jcjones94/drone/tutorial/parts.md

# List of parts with model number

* mpu 6050 gryo/accelerometer 

* Makerfire ESC 20A BLHeli Brushless Speed Controller

* Elegoo UNO R3 Board ATmega328P

* UCEC XY-MK-5V / XY-FST 433Mhz Rf Transmitter and Receiver

* A2212 1000KV Brushless Outrunner Motor

* 3 cell 3300mha 25-50c lipo battery
