jcjones94/drone/(threads)

Thread 1 (2017-07-06):

drone drift

jcjones94, 2017-07-06:
with my current code the drone continues to drift. I've tried adjusting the power to the motors but this process is tedious.  the drift is most likely because the gyro isn't level on the drone and the gyro/accelerometer has values that drift over time.

jcjones94, 2017-08-11:
I've found out that the drifting of the drone is most likely do to vibrations effecting the MPU6050. i believe the vibrations are so strong that its causing a buffer overflow on the acceleration data in the x and y plane which is causing angle shifts. I've concluded this because once the drones throttle reaches the point at which the drone is able to fly the angle data shifts even if i'm holding the drone down on a flat surface. the angle shifts increase the more throttle i give the drone. To fix this problem i need to get new propellers and having them balanced(current props have been super glued together multiple times so no hope for them). I'm also going to try decreasing the sensitivity of the acceleration data coming from the MPU6050

Thread 2 (2017-08-13):

No need to wait after Wire.requestFrom()

Koepel, 2017-08-13:
In the file "FlightController2.ino", the Wire.requestFrom() is followed by a while-loop to wait for something. That while-loop can be removed. There is nothing to wait for.

The Wire.requestFrom() does a complete I2C transaction and waits until the data is received and the I2C transaction has finished. When it returns the received data is waiting in a buffer in the Wire library.

fqlx, 2017-08-13:
Thanks for letting us know @Koepel
